eldoberino/arduino-hdq-mock-bms/img/all-together.jpg

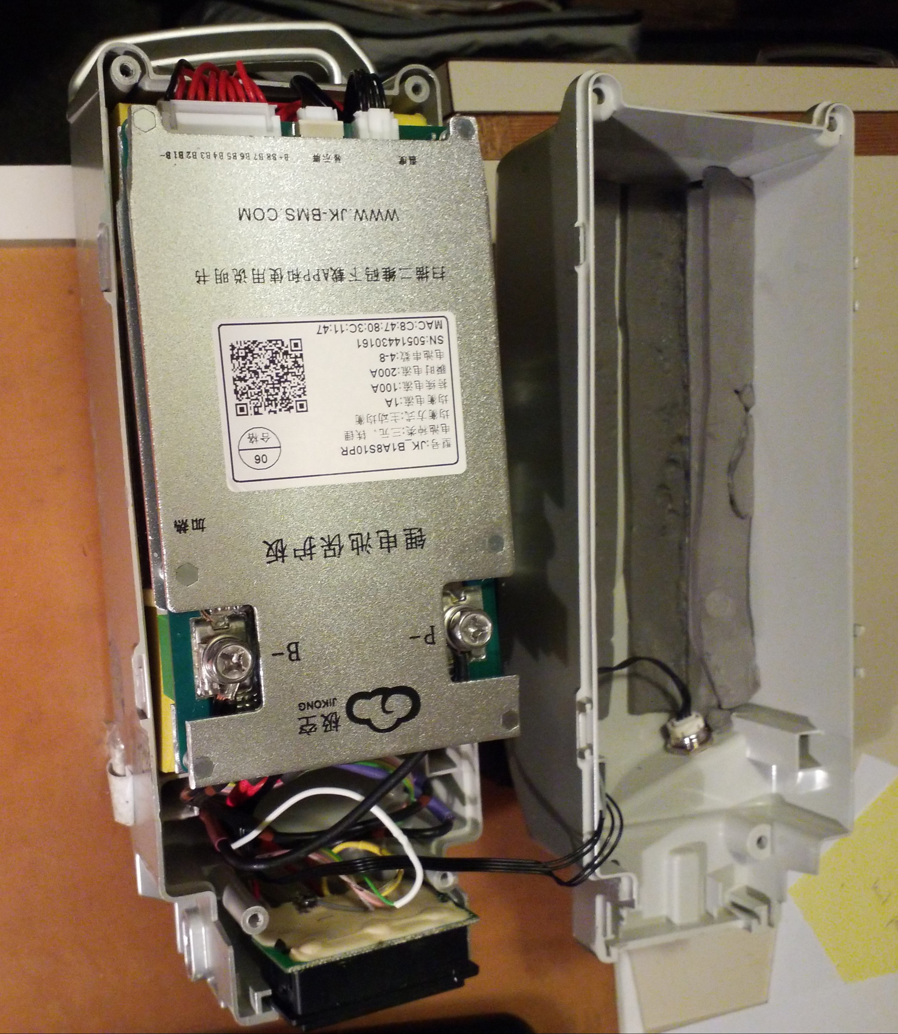
img/all-together.jpg
