eldoberino/arduino-hdq-mock-bms/img/pcb-in-housing.jpg

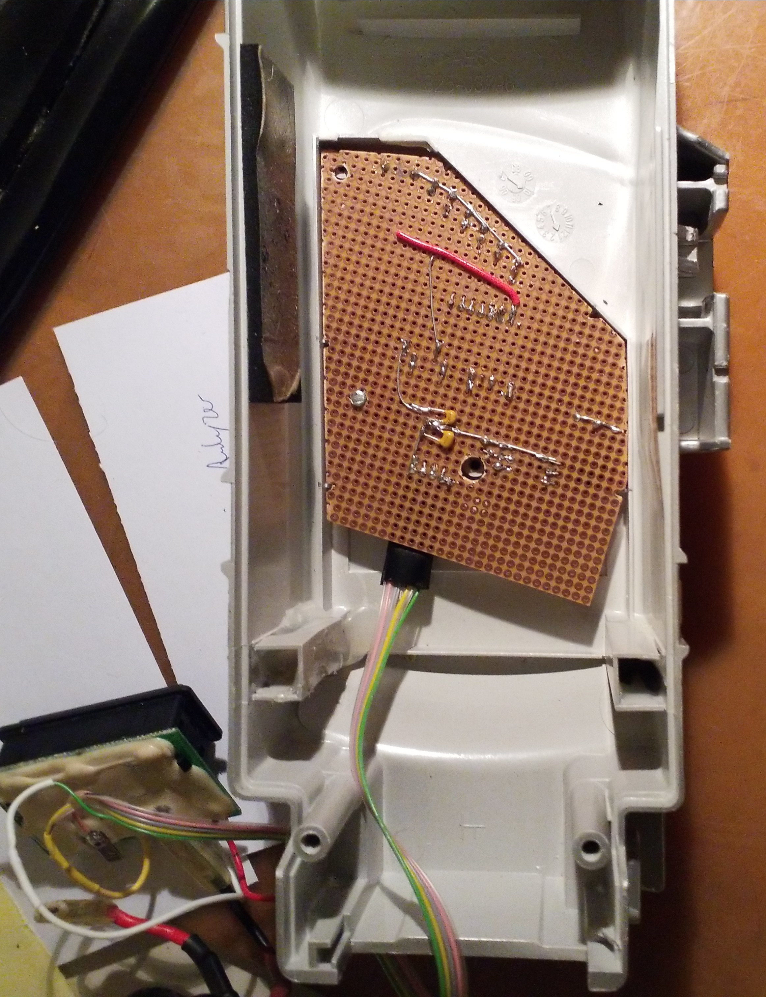
img/pcb-in-housing.jpg
